LeastSignificantBit/FreqSynth/FreqSynth.kicad_pcb

## KiCad design FreqSynth.kicad_pcb (2016-09-24)

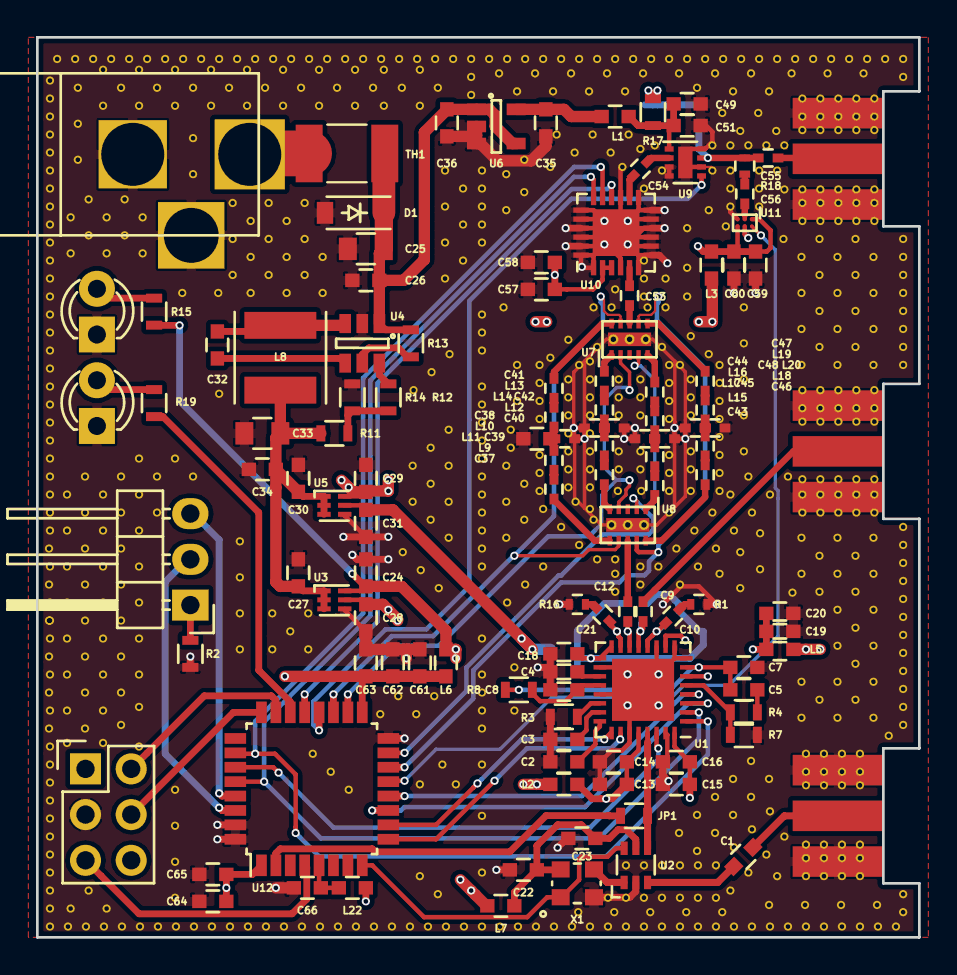
[picture p1: board FreqSynth.kicad_pcb from above]

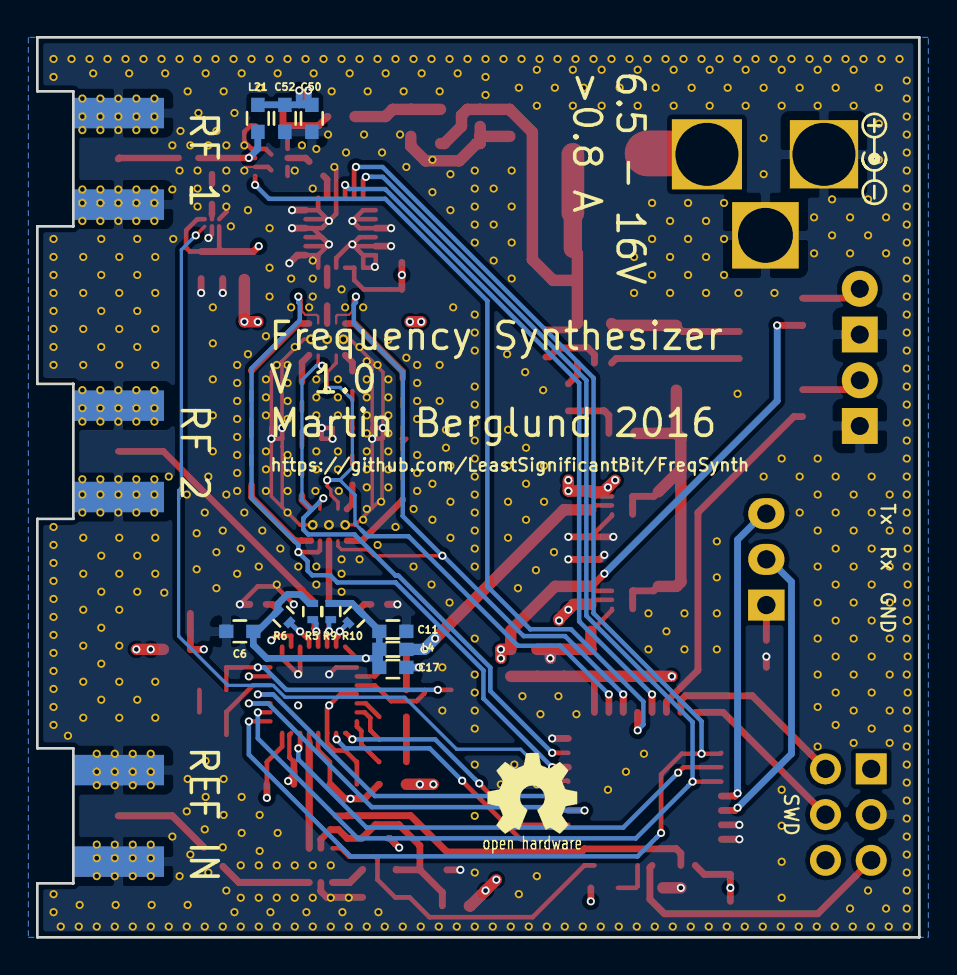
[picture p2: board FreqSynth.kicad_pcb from below]

Board: 4 copper layers, 49.0 x 50.0 mm, 131 parts (11 on the bottom side), 96 nets.

Parts:
C1, C6, C11, C13, C15, C17, C19, C22, C50, C57, C59, C62, C64, C66: 10nF; C_0603
C2, C3, C4: 1uF; C_0603
C5, C36, C51: 100nF; C_0603
C7: 12nF; C_0603
C8: 820pF; C_0603
C9, C10, C12, C21, C53, C54, C55, C56: 1nF_RF; C_0402
C14, C16, C18, C20, C23, C58, C60, C63, C65: 100pF; C_0603
C24, C26, C27, C28, C29, C30, C31, C32, C34, C35, C49, C61: 1µF; C_0603
C25, C33: 22µF 16V; C_0805
C37, C38: 100pF_RF; C_0402
C39: 6pF_RF; C_0402
C40, C41: 0.5pF_RF; C_0402
C42: 2pF_RF; C_0402
C43, C44: 0.8pF_RF; C_0402
C45: 4pF_RF; C_0402
C46, C47: 2.4pF_RF; C_0402
C48: 5pF_RF; C_0402
C52: 10pF; C_0603
D1: CPL-DIO-MBR0520; SOD-123
D2: GREEN; LED-3MM
D3: YELLOW; LED-3MM
JP1: Jumper_NC_Small; R_0603
L1, L2, L3, L4, L5, L6, L7, L22: Ferrite; L_0603
L8: 6.8µH 2.5A; NRS5030T6R8MMGJ
L9, L10: 8nH; L_0402
L11: 200nH; L_0603
L12, L13: 2.5nH; L_0402
L14: 0.6nH; L_0402
L15, L16: 5nH; L_0402
L17: 1nH; L_0402
L18, L19: 6.1nH; L_0402
L20: 3nH; L_0402
L21: 100nH; L_0603
P1: CPL-CON-BARREL-2.1MM; BARREL_JACK
P2: RF1; SMA_edge
P3: RF2; SMA_edge
P4: CONN_01X03; Pin_Header_Angled_1x03
P5: REF_IN; SMA_edge
P6: SWD; Pin_Header_Straight_2x03
R1, R5, R6, R9, R10, R16: 49.9R; R_0402
R2: 0R; R_0603
R3: 5.1k; R_0603
R4: 30.1R; R_0603
R7: 90.9R; R_0603
R8: 240R; R_0603
R11: 45.3k; R_0603
R12: 59k; R_0603
R13: 100k; R_0603
R14: 11.3k; R_0603
R15, R19: 180R; R_0603
R17: 1.8R; R_0603
R18: 100R; R_0402
TH1: 750mA working 1.5A trip; SMD_THERMISTOR
U1: MAX2870; QFN-32-1EP_5x5mm_Pitch0.5mm
U2: TS5A3159; SC-70-6
U3, U5: TLV7113333DDSET; WSON-6
U4: AP65101; SOT-23-6
U6: RT9069-50GB; SOT-23-5
U7, U8: SKY13322-375LF; MLPD-10
U9: TRF37A75; DFN-8-1EP_2x2mm_Pitch0.5mm
U10: PE43711; QFN-24-1EP_4x4mm_Pitch0.5mm
U11: LMH2110; WFBGA-6
U12: STM32F030K6T6; LQFP-32_7x7mm_Pitch0.8mm
X1: 25MHz ±5ppm 3.3V 33mA; OSC_2.7x2.4mm

Connections:
/3v3: C29.2, L3.1, L7.1, U5.6
/5V5: C35.1, L1.1, U6.5
/Amplifier/3V3: C57.1, C58.1, C59.1, C60.1, L3.2, U10.2, U10.3, U11.A1, U11.C2
/Amplifier/ATTEN_CS: U10.16, U12.21
/Amplifier/PWDN: U9.5, U12.20
/Amplifier/RF_IN: C53.2, U7.8
/Amplifier/RF_OUT: C55.1, P2.1
/Amplifier/VCC_AMP: C49.2, C51.2, L1.2, R17.1, U9.1
/Clock/3V3: C22.1, C23.1, L7.2, U2.5, X1.4
/Clock/EXT_REF: C1.1, U2.3
/FILT1: U7.9, U8.7, U12.19
/FILT2: U7.7, U8.9, U12.14
/FILT3: U7.4, U8.2, U12.15
/FILT4: U7.2, U8.4, U12.18
/MCU/ADC1: U11.A2, U12.13
/MCU/CE_PLL: U1.4, U12.12
/MCU/CLK_IN: JP1.2, U12.2
/MCU/CS_PLL: U1.3, U12.11
/MCU/EN_PLL: U1.26, U12.9
/MCU/INT_CLK_EN: U2.6, U12.8, X1.1
/MCU/LD_PLL: U1.25, U12.10
/MCU/RX: P4.2, U12.30
/MCU/TX: P4.3, U12.29
/MCU/VCC_D: C61.1, C62.1, C63.1, C64.1, C65.1, L6.2, L22.1, P6.1, U12.1, U12.17
/MISO: U1.30, U12.27
/MOSI: U1.2, U10.18, U12.28
/PLL/CLK_REF: JP1.1, U1.29, U2.4
/PLL/RF+: C12.1, U8.8
/PLL/RF-: C21.1, R16.1
/PLL/RFA_N: C9.2, R5.2, U1.13
/PLL/RFA_P: C10.2, R6.2, U1.12
/PLL/RFB_N: C21.2, R10.2, U1.15
/PLL/RFB_P: C12.2, R9.2, U1.14
/PLL/RF_BALANCED+: C10.1, R1.1
/PLL/RF_BALANCED-: C9.1, P3.1
/PLL/TUNE: C8.2, R8.1, U1.20
/PLL/VCC_D: C13.1, C14.1, C15.1, C16.1, L2.2, U1.28, U1.32
/PLL/VCC_PLL: C19.1, C20.1, L5.2, U1.6, U1.10
/PLL/VCC_RF: C6.1, C11.1, C17.1, C18.1, L4.2, R5.1, R6.1, R9.1, R10.1, U1.16, U1.17
/Power/4V0: C27.1, C30.1, C33.1, C34.1, L8.2, R11.2, U3.1, U3.2, U3.3, U5.1, U5.2, U5.3
/Power/VCC_D: C24.2, L2.1, L6.1, R15.1, U3.6
/Power/VCC_PLL: C28.1, L5.1, U3.5
/Power/VCC_RF: C31.1, L4.1, U5.5
/Power/VIN: C25.1, C26.1, C36.1, D1.1, R13.1, TH1.1, U4.1, U6.1, U6.4
/SCK: U1.1, U10.17, U12.26
Earth: C2.1, C3.1, C4.1, C6.2, C7.1, C8.1, C11.2, C13.2, C14.2, C15.2, C16.2, C17.2, C18.2, C19.2, C20.2, C22.2, C23.2, C24.1, C25.2, C26.2, C27.2, C28.2, C29.1, C30.2, C31.2, C33.2, C34.2, C35.2, C36.2, C39.2, C42.2, C45.2, C48.2, C49.1, C50.2, C51.1, C52.1, C57.2, C58.2, C59.2, C60.2, C61.2, C62.2, C63.2, C64.2, C65.2, C66.2, D1.2, D2.1, D3.1, L11.2, L14.2, L17.2, L20.2, P1.2, P1.3, P2.2, P3.2, P5.2, P6.3, R1.2, R2.2, R3.1, R7.1, R14.1, R16.2, U1.8, U1.9, U1.11, U1.18, U1.21, U1.27, U1.31, U1.33, U2.2, U3.4, U4.2, U5.4, U6.2, U6.3, U7.11, U8.11, U9.3, U9.4, U9.6, U9.8, U9.9, U10.1, U10.4, U10.6, U10.7, U10.8, U10.9, U10.10, U10.11, U10.12, U10.13, U10.15, U10.19, U10.20, U10.21, U10.22, U10.23, U10.24, U10.25, U11.B2, U11.C1, U12.16, U12.31, U12.32, X1.2
unnamed: C1.2, P5.1
unnamed: C2.2, U1.24
unnamed: C3.2, U1.23
unnamed: C4.2, U1.19
unnamed: C5.1, C7.2, R8.2, U1.7
unnamed: C5.2, R4.1
unnamed: C32.1, U4.4
unnamed: C32.2, L8.1, U4.3
unnamed: C37.1, U8.6
unnamed: C37.2, L9.2
unnamed: C38.1, L10.2
unnamed: C38.2, U7.10
unnamed: C39.1, L9.1, L10.1, L11.1
unnamed: C40.1, U8.5
unnamed: C40.2, L12.2
unnamed: C41.1, U7.1
unnamed: C41.2, L13.2
unnamed: C42.1, L12.1, L13.1, L14.1
unnamed: C43.1, U8.1
unnamed: C43.2, L15.2
unnamed: C44.1, U7.5
unnamed: C44.2, L16.2
unnamed: C45.1, L15.1, L16.1, L17.1
unnamed: C46.1, U8.10
unnamed: C46.2, L18.2
unnamed: C47.1, U7.6
unnamed: C47.2, L19.2
unnamed: C48.1, L18.1, L19.1, L20.1
unnamed: C50.1, C52.2, L21.1, R17.2
unnamed: C53.1, U10.5
unnamed: C54.1, U9.2
unnamed: C54.2, U10.14
unnamed: C55.2, L21.2, R18.1, U9.7
unnamed: C56.1, U11.B1
unnamed: C56.2, R18.2
unnamed: C66.1, L22.2, U12.5
unnamed: D2.2, R15.2
unnamed: D3.2, R19.2
unnamed: P1.1, TH1.2
unnamed: P4.1, R2.1
unnamed: P6.2, U12.23
unnamed: P6.4, U12.24
unnamed: P6.5, U12.4
unnamed: R3.2, U1.22
unnamed: R4.2, R7.2, U1.5
unnamed: R11.1, R12.1, R14.2
unnamed: R12.2, U4.6
unnamed: R13.2, U4.5
unnamed: R19.1, U12.22
unnamed: U2.1, X1.3
