LeastSignificantBit/FreqSynth/firmware/Inc/mxconstants.h

/**
  ******************************************************************************
  * File Name          : mxconstants.h
  * Description        : This file contains the common defines of the application
  ******************************************************************************
  *
  * COPYRIGHT(c) 2016 STMicroelectronics
  *
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
  ******************************************************************************
  */
/* Define to prevent recursive inclusion -------------------------------------*/
#ifndef __MXCONSTANT_H
#define __MXCONSTANT_H
  /* Includes ------------------------------------------------------------------*/


#define INT_CLK_EN_Pin GPIO_PIN_2
#define INT_CLK_EN_GPIO_Port GPIOA
#define EN_PLL_Pin GPIO_PIN_3
#define EN_PLL_GPIO_Port GPIOA
#define LD_PLL_Pin GPIO_PIN_4
#define LD_PLL_GPIO_Port GPIOA
#define CS_PLL_Pin GPIO_PIN_5
#define CS_PLL_GPIO_Port GPIOA
#define CE_PLL_Pin GPIO_PIN_6
#define CE_PLL_GPIO_Port GPIOA
#define ADC_POWER_DET_Pin GPIO_PIN_7
#define ADC_POWER_DET_GPIO_Port GPIOA
#define FILT2_Pin GPIO_PIN_0
#define FILT2_GPIO_Port GPIOB
#define FILT3_Pin GPIO_PIN_1
#define FILT3_GPIO_Port GPIOB
#define FILT4_Pin GPIO_PIN_8
#define FILT4_GPIO_Port GPIOA
#define FILT1_Pin GPIO_PIN_9
#define FILT1_GPIO_Port GPIOA
#define PWDWN_Pin GPIO_PIN_10
#define PWDWN_GPIO_Port GPIOA
#define ATTEN_CS_Pin GPIO_PIN_11
#define ATTEN_CS_GPIO_Port GPIOA
#define RED_LED_Pin GPIO_PIN_12
#define RED_LED_GPIO_Port GPIOA
/**
  * @}
  */ 

/**
  * @}
*/ 

#endif /* __MXCONSTANT_H */
/************************ (C) COPYRIGHT STMicroelectronics *****END OF FILE****/
