LeastSignificantBit/FreqSynth/(commit log)

2016-08-29 fixed broken stuff
    [ClockRef.sch, Controller.sch, Filter.sch, FreqSynth.sch, PLL.sch, Power.sch]
2016-08-30 multiple additions
    [ClockRef.sch, Controller.sch, Filter.sch, FreqSynth.sch, PLL.sch, Power.sch]
2016-08-30 added amplifier
    [Amplifier.sch, Filter.sch, FreqSynth.sch, Power.sch]
2016-08-31 Set the designrules to match 4 layer OSHpark DRC
    [FreqSynth.kicad_pcb]
2016-08-31 Fixed Amplifier, Added manf# field, ERC cleanup
    [Amplifier.sch, ClockRef.sch, Controller.sch, Filter.sch, FreqSynth.kicad_pcb, FreqSynth.sch, PLL.sch, Power.sch]
2016-09-01 Removed rescuelib
    [Amplifier.sch, ClockRef.sch, Controller.sch, Filter.sch, FreqSynth.sch, PLL.sch, Power.sch]
2016-09-01 Added some inductor values
    [Amplifier.sch, ClockRef.sch, Controller.sch, Filter.sch, FreqSynth.sch, PLL.sch, Power.sch]
2016-09-01 small edit
    [Amplifier.sch, ClockRef.sch, Controller.sch, Filter.sch, FreqSynth.sch, PLL.sch, Power.sch]
2016-09-02 Added manf# to most of the parts
    [Amplifier.sch, ClockRef.sch, Controller.sch, Filter.sch, FreqSynth.sch, PLL.sch, Power.sch]
2016-09-02 Started on the board even though theres some components missing
    [Amplifier.sch, ClockRef.sch, Controller.sch, Filter.sch, FreqSynth.kicad_pcb, FreqSynth.sch, PLL.sch, Power.sch]
2016-09-02 Added a todolist and solved som small crap
    [Amplifier.sch, ClockRef.sch, Controller.sch, Filter.sch, FreqSynth.kicad_pcb, FreqSynth.sch, PLL.sch, Power.sch]
2016-09-03 Outline starts to come togeter
    [FreqSynth.kicad_pcb]
2016-09-03 Fixed USB mini B
    [Amplifier.sch, ClockRef.sch, Controller.sch, Filter.sch, FreqSynth.kicad_pcb, FreqSynth.sch, PLL.sch, Power.sch]
2016-09-03 Added power meter, swaped some pins, and routetd most of the RF
    [Amplifier.sch, ClockRef.sch, Controller.sch, Filter.sch, FreqSynth.kicad_pcb, FreqSynth.sch, PLL.sch, Power.sch]
2016-09-04 Starting to clean up
    [Amplifier.sch, ClockRef.sch, Controller.sch, Filter.sch, FreqSynth.kicad_pcb, FreqSynth.sch, PLL.sch, Power.sch]
2016-09-05 Board layout almost done
    [Amplifier.sch, ClockRef.sch, Controller.sch, Filter.sch, FreqSynth.kicad_pcb, FreqSynth.sch, PLL.sch, Power.sch]
2016-09-05 Board layout done, no ERC or DRC:s left
    [FreqSynth.kicad_pcb, FreqSynth.sch]
2016-09-10 Major rework
    Removed star ground.
    Switched MCU.
    Smaller board outline - Ripped up almost the entire ratsnest.
    Eliminated one crystal.
    No more USB
    New debug header
    Eliminated reset switch
    Only single ended RF2
    And much more
    [Amplifier.sch, ClockRef.sch, Controller.sch, Filter.sch, FreqSynth.kicad_pcb, FreqSynth.sch, PLL.sch, Power.sch]
2016-09-10 Finished routing the preliminary layout
    [Amplifier.sch, ClockRef.sch, Controller.sch, Filter.sch, FreqSynth.kicad_pcb, FreqSynth.sch, PLL.sch, Power.sch]
2016-09-11 Added new leds and switched swd header to 0.1" instead of jst
    [Amplifier.sch, ClockRef.sch, Controller.sch, Filter.sch, FreqSynth.kicad_pcb, FreqSynth.sch, PLL.sch, Power.sch]
2016-09-11 Added some missing part numbers
    [Amplifier.sch, Controller.sch, Filter.sch, FreqSynth.sch, Power.sch]
2016-09-12 fixed the barreljack
    [Controller.sch, FreqSynth.kicad_pcb, FreqSynth.sch, Power.sch]
2016-09-12 All ICS duble-checked! some RF solved
    [Controller.sch, FreqSynth.kicad_pcb, FreqSynth.sch]
2016-09-13 reroutet the entire board
    [Amplifier.sch, ClockRef.sch, Controller.sch, Filter.sch, FreqSynth.kicad_pcb, FreqSynth.sch, PLL.sch, Power.sch]
2016-09-13 Almost finished, Via stitching in place plus decals
    [FreqSynth.kicad_pcb]
2016-09-13 RC2
    Fixed oval holes that are not allowed and set the solder mask parameters to the limit
    [FreqSynth-B.Cu.gbr, FreqSynth-B.Mask.gbr, FreqSynth-B.SilkS.gbr, FreqSynth-Edge.Cuts.gbr, FreqSynth-F.Cu.gbr, FreqSynth-F.Mask.gbr, FreqSynth-F.Paste.gbr, FreqSynth-F.SilkS.gbr]
2016-09-24 RC3 - fixed soldermask
    [FreqSynth-B.Cu.gbr, FreqSynth-B.Mask.gbr, FreqSynth-B.SilkS.gbr, FreqSynth-Edge.Cuts.gbr, FreqSynth-F.Cu.gbr, FreqSynth-F.Mask.gbr, FreqSynth-F.Paste.gbr, FreqSynth-F.SilkS.gbr]
2016-10-01 Fixed a Command interface for the firmware
    Added a small test routine to main to demonstrate/test
    [comminterface.cpp, comminterface.h, main.cpp]
2016-10-15 Switched library to the default output from STM32Cube
2016-10-18 Added a tiny printf to help with printing
2017-01-22 start to check for errors
    [basic.py, main.cpp, max2870.py]
