LeastSignificantBit/FreqSynth/(notices)

Notices in the files:
firmware/Src/main.cpp:
Copyright (C) 2016 Martin Berglund
